MIDKINGIELIA/Protect/Clutch_Ctrl_BD_Rev010/30000009_Clutch_Ctrl_BD_Rev010.SLDPRT

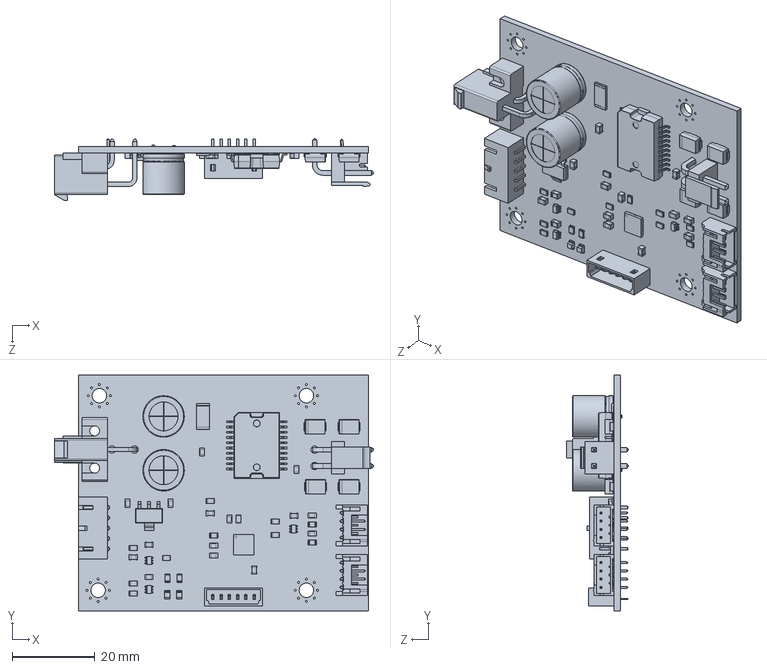
[picture p1: CAD file, 2022-12-25]
Clutch_Ctrl_BD_Rev010/30000009_Clutch_Ctrl_BD_Rev010.SLDPRT
77.0 x 57.0 x 14.9 mm
