MIDKINGIELIA/Protect/Clutch_Ctrl_BD_Rev010/Clutch_Ctrl_BD_Rev010.kicad_pcb

## KiCad design Clutch_Ctrl_BD_Rev010/Clutch_Ctrl_BD_Rev010.kicad_pcb (2022-12-25)

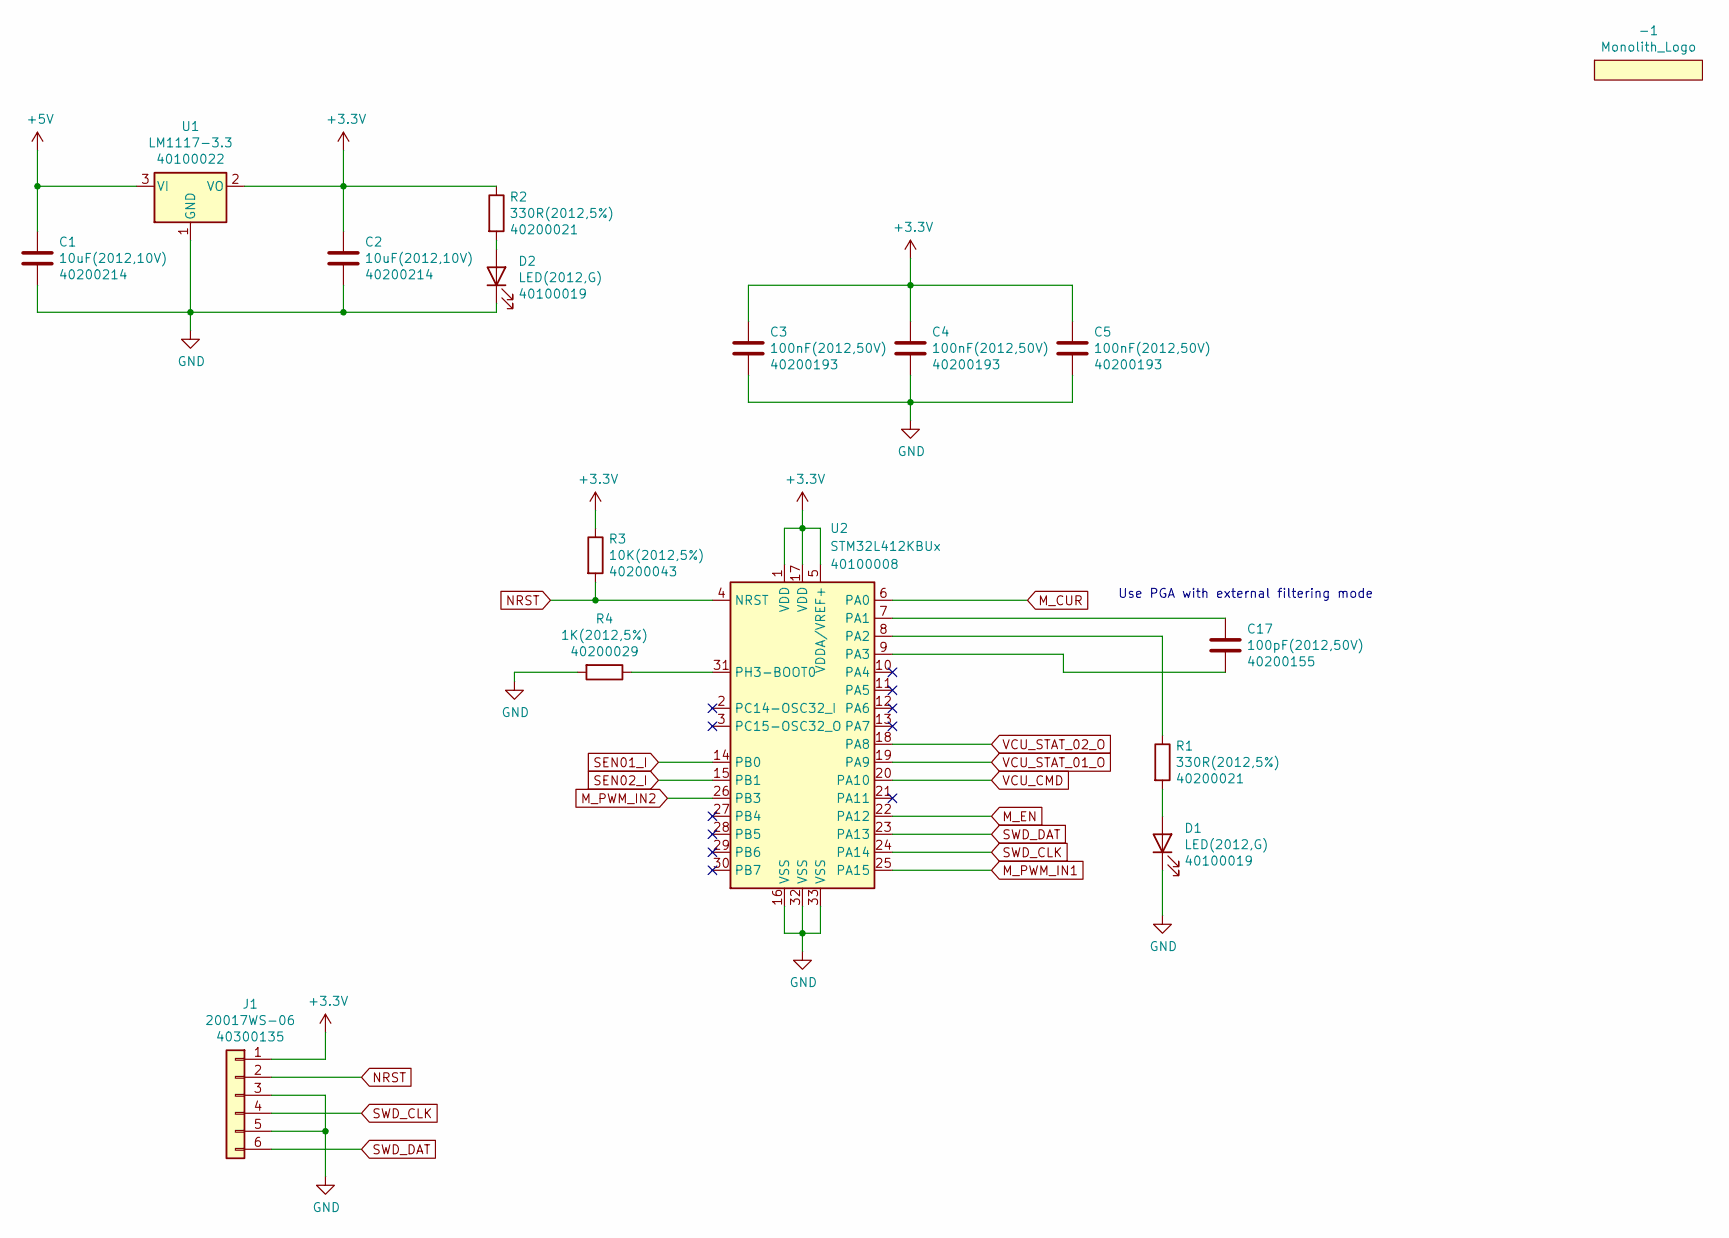
[picture p7: schematic POWER_CPU.sch, POWER & CPU]

Parts:
-1: Monolith_Logo
C1, C2: 10uF(2012,10V); C_0805_2012Metric; PartNo 40200214
C3, C4, C5: 100nF(2012,50V); C_0805_2012Metric; PartNo 40200193
C17: 100pF(2012,50V); C_0805_2012Metric; PartNo 40200155
D1, D2: LED(2012,G); LED_0805_2012Metric; PartNo 40100019
J1: 20017WS-06; Yeonho_20017WS-06_P2.0mm; PartNo 40300135
R1, R2: 330R(2012,5%); R_0805_2012Metric; PartNo 40200021
R3: 10K(2012,5%); R_0805_2012Metric; PartNo 40200043
R4: 1K(2012,5%); R_0805_2012Metric; PartNo 40200029
U1: LM1117-3.3; SOT-223-3_TabPin2; PartNo 40100022
U2: STM32L412KBUx; QFN-32-1EP_5x5mm_P0.5mm_EP3.45x3.45mm; PartNo 40100008

Connections:
+3V3: C2.1, C3.1, C4.1, C5.1, J1.1, R2.1, R3.1, U1.2 (VO), U2.1 (VDD), U2.5 (VDDA/VREF+), U2.17 (VDD); also elsewhere on the board
+5V: C1.1, U1.3 (VI); also elsewhere on the board
GND: C1.2, C2.2, C3.2, C4.2, C5.2, D1.1 (K), D2.1 (K), J1.3, J1.5, R4.2, U1.1 (GND), U2.16 (VSS), U2.32 (VSS), U2.33 (VSS); also elsewhere on the board
M_CUR: U2.6 (PA0); also elsewhere on the board
M_EN: U2.22 (PA12); also elsewhere on the board
M_PWM_IN1: U2.25 (PA15); also elsewhere on the board
M_PWM_IN2: U2.26 (PB3); also elsewhere on the board
NRST: J1.2, R3.2, U2.4 (NRST)
unnamed: C17.1, U2.7 (PA1)
unnamed: C17.2, U2.9 (PA3)
unnamed: D1.2 (A), R1.2
unnamed: D2.2 (A), R2.2
unnamed: R1.1, U2.8 (PA2)
unnamed: R4.1, U2.31 (PH3-BOOT0)
SEN01_I: U2.14 (PB0); also elsewhere on the board
SEN02_I: U2.15 (PB1); also elsewhere on the board
SWD_CLK: J1.4, U2.24 (PA14)
SWD_DAT: J1.6, U2.23 (PA13)
VCU_CMD: U2.20 (PA10); also elsewhere on the board
VCU_STAT_01_O: U2.19 (PA9); also elsewhere on the board
VCU_STAT_02_O: U2.18 (PA8); also elsewhere on the board

Notes on the sheet:
Use PGA with external filtering mode

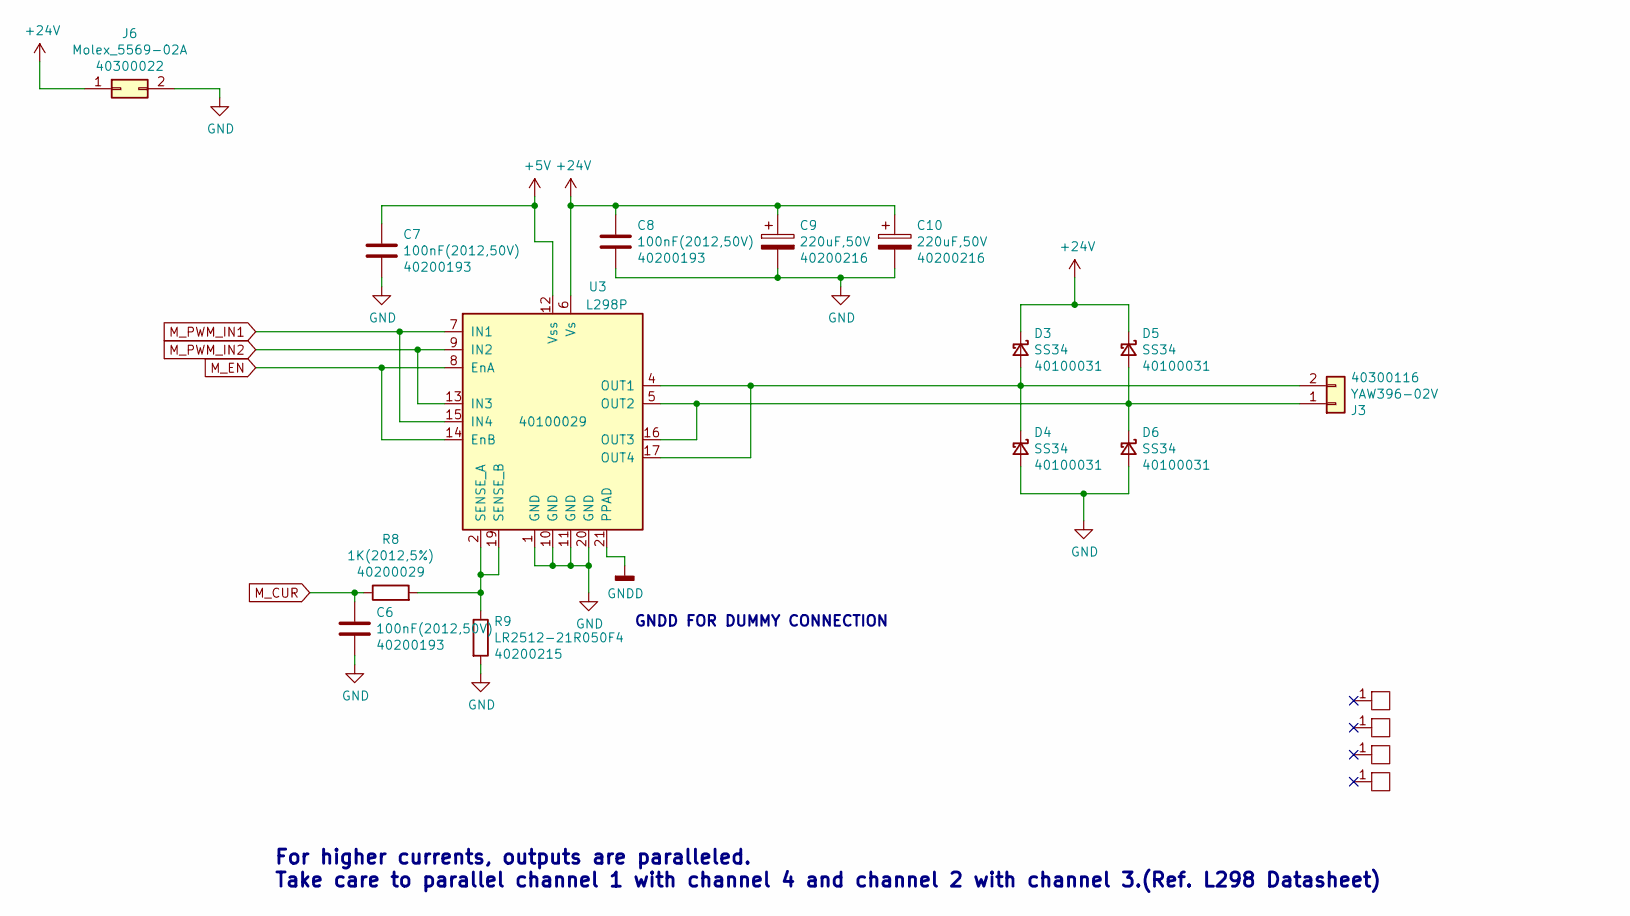
[picture p8: schematic DCM_Driver.sch, DC MOTOR]

Parts:
C6, C7, C8: 100nF(2012,50V); C_0805_2012Metric; PartNo 40200193
C9, C10: 220uF,50V; CP_Radial_D10.0mm_P5.00mm; PartNo 40200216
D3, D4, D5, D6: SS34; D_SMB; PartNo 40100031
H1, H2, H3, H4: PTH-HOLE-M3-CIRCLE; PTH-CIRCLE-M3
J3: YAW396-02V; PartNo 40300116
J6: Molex_5569-02A; Molex_Mini-Fit_Jr_5569-02A1_2x01_P4.20mm_Horizontal; PartNo 40300022
R8: 1K(2012,5%); R_0805_2012Metric; PartNo 40200029
R9: LR2512-21R050F4; R_2512_6332Metric; PartNo 40200215
U3: L298P; HSOP-20-1EP_11.0x15.9mm_P1.27mm_SlugDown; PartNo 40100029

Connections:
+5V: C7.1, U3.12 (Vss); also elsewhere on the board
+24V: C8.1, C9.1, C10.1, D3.1 (K), D5.1 (K), J6.1, U3.6 (Vs)
GND: C6.2, C7.2, C8.2, C9.2, C10.2, D4.2 (A), D6.2 (A), J6.2, R9.2, U3.1 (GND), U3.10 (GND), U3.11 (GND), U3.20 (GND); also elsewhere on the board
GNDD: U3.21 (PPAD)
M_CUR: C6.1, R8.1; also elsewhere on the board
M_EN: U3.8 (EnA), U3.14 (EnB); also elsewhere on the board
M_PWM_IN1: U3.7 (IN1), U3.15 (IN4); also elsewhere on the board
M_PWM_IN2: U3.9 (IN2), U3.13 (IN3); also elsewhere on the board
unnamed: D3.2 (A), D4.1 (K), J3.2, U3.4 (OUT1), U3.17 (OUT4)
unnamed: D5.2 (A), D6.1 (K), J3.1, U3.5 (OUT2), U3.16 (OUT3)
unnamed: R8.2, R9.1, U3.2 (SENSE_A), U3.19 (SENSE_B)

Notes on the sheet:
For higher currents, outputs are paralleled. Take care to parallel channel 1 with channel 4 and channel 2 with channel 3.(Ref. L298 Datasheet)
GNDD FOR DUMMY CONNECTION

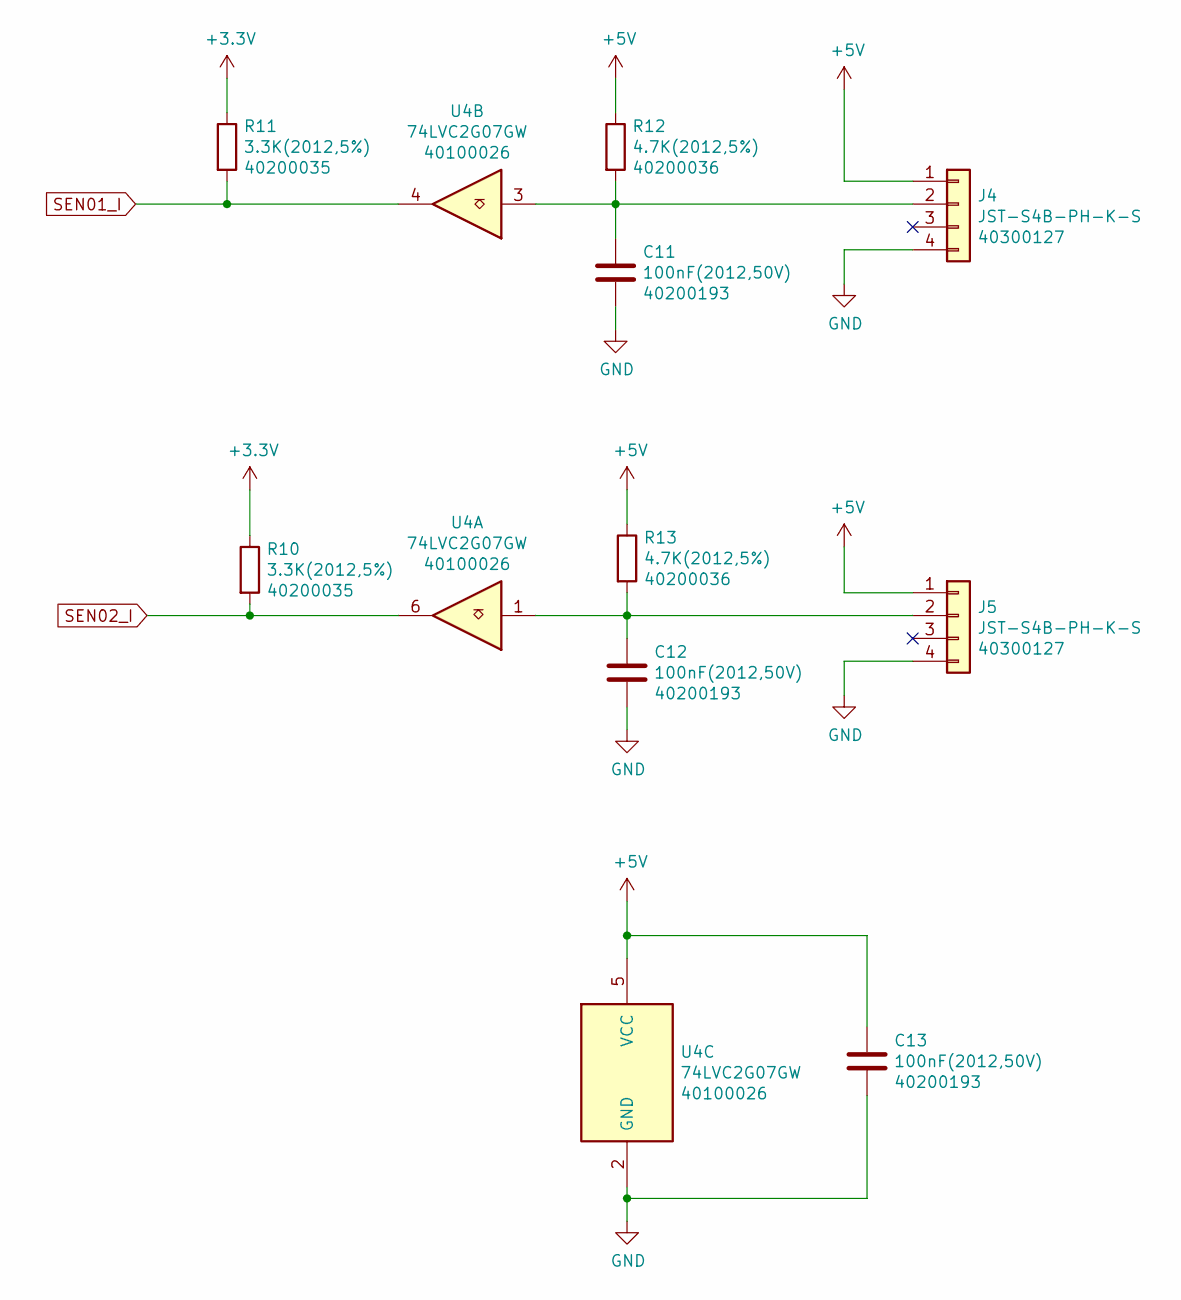
[picture p9: schematic SENSOR.sch, SENSOR IF]

Parts:
C11, C12, C13: 100nF(2012,50V); C_0805_2012Metric; PartNo 40200193
J4, J5: JST-S4B-PH-K-S; JST_PH_S4B-PH-K_1x04_P2.00mm_Horizontal; PartNo 40300127
R10, R11: 3.3K(2012,5%); R_0805_2012Metric; PartNo 40200035
R12, R13: 4.7K(2012,5%); R_0805_2012Metric; PartNo 40200036
U4: 74LVC2G07GW; SOT-363_SC-70-6; PartNo 40100026

Connections:
+3V3: R10.1, R11.1; also elsewhere on the board
+5V: C13.1, J4.1, J5.1, R12.1, R13.1, U4.5 (VCC); also elsewhere on the board
GND: C11.2, C12.2, C13.2, J4.4, J5.4, U4.2 (GND); also elsewhere on the board
unnamed: C11.1, J4.2, R12.2, U4.3
unnamed: C12.1, J5.2, R13.2, U4.1
SEN01_I: R11.2, U4.4; also elsewhere on the board
SEN02_I: R10.2, U4.6; also elsewhere on the board

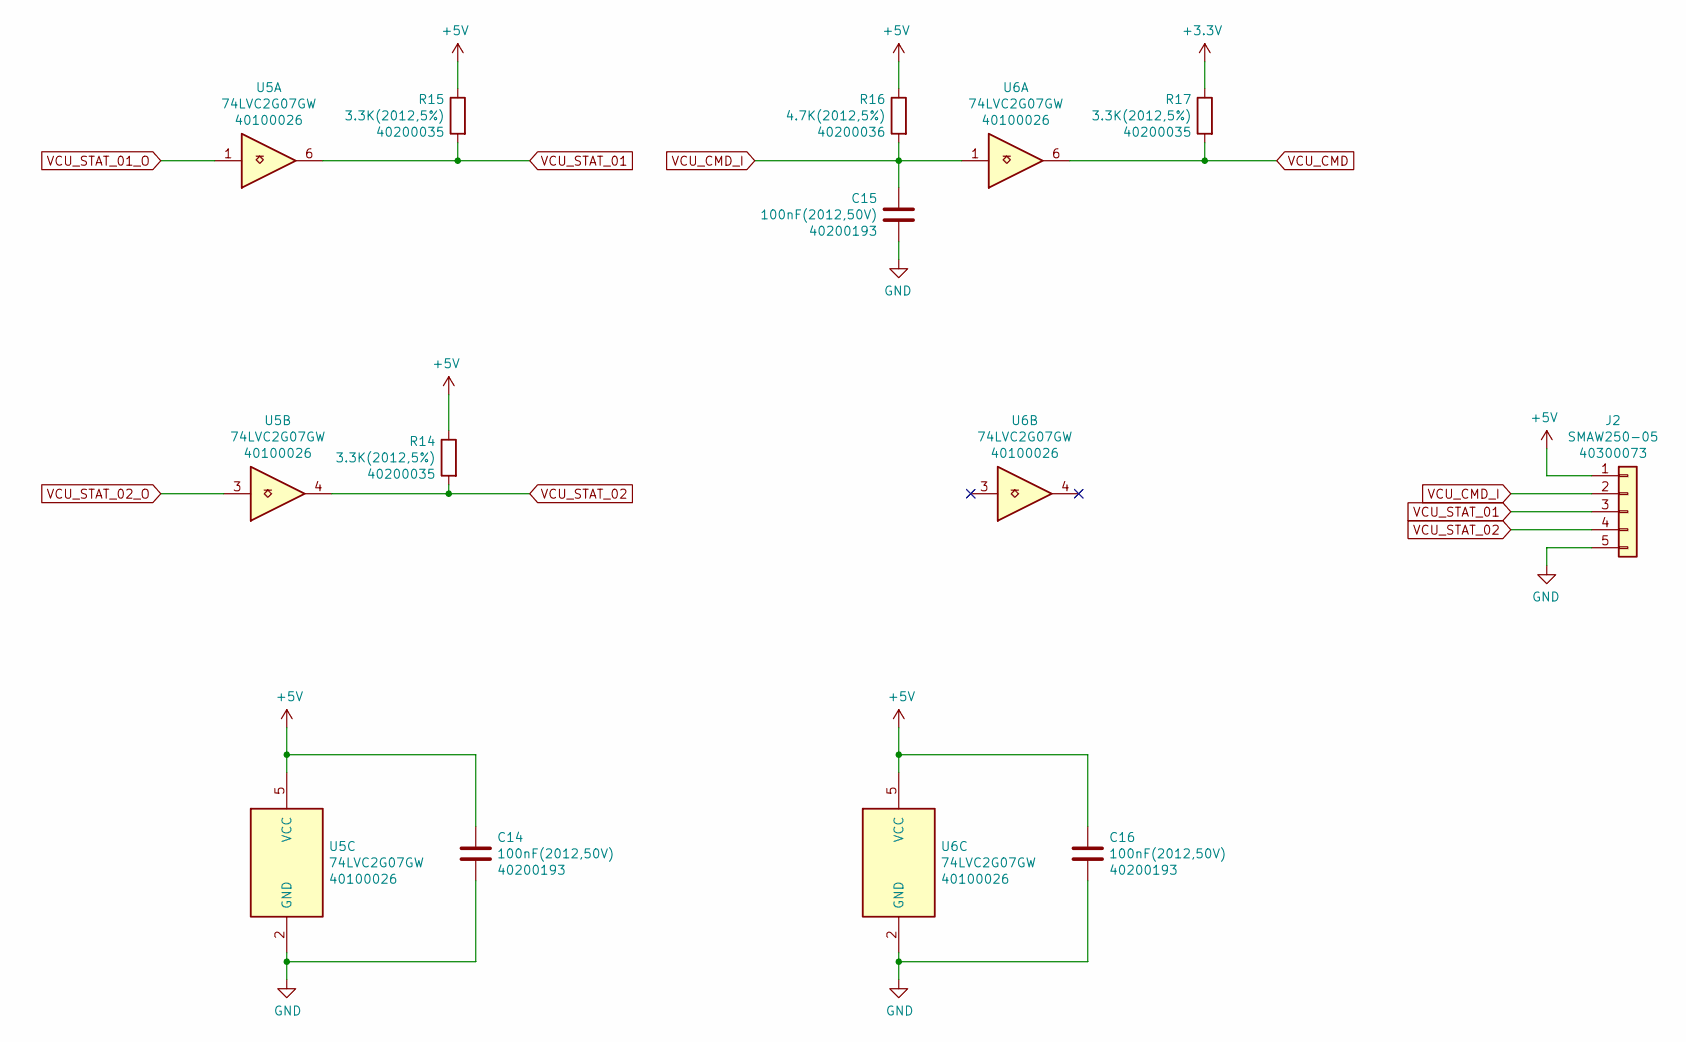
[picture p10: schematic VCU_IF.sch, VCU IF]

Parts:
C14, C15, C16: 100nF(2012,50V); C_0805_2012Metric; PartNo 40200193
J2: SMAW250-05; PartNo 40300073
R14, R15, R17: 3.3K(2012,5%); R_0805_2012Metric; PartNo 40200035
R16: 4.7K(2012,5%); R_0805_2012Metric; PartNo 40200036
U5, U6: 74LVC2G07GW; SOT-363_SC-70-6; PartNo 40100026

Connections:
+3V3: R17.1; also elsewhere on the board
+5V: C14.1, C16.1, J2.1, R14.1, R15.1, R16.1, U5.5 (VCC), U6.5 (VCC); also elsewhere on the board
GND: C14.2, C15.2, C16.2, J2.5, U5.2 (GND), U6.2 (GND); also elsewhere on the board
VCU_CMD: R17.2, U6.6; also elsewhere on the board
VCU_CMD_I: C15.1, J2.2, R16.2, U6.1
VCU_STAT_01: J2.3, R15.2, U5.6
VCU_STAT_01_O: U5.1; also elsewhere on the board
VCU_STAT_02: J2.4, R14.2, U5.4
VCU_STAT_02_O: U5.3; also elsewhere on the board

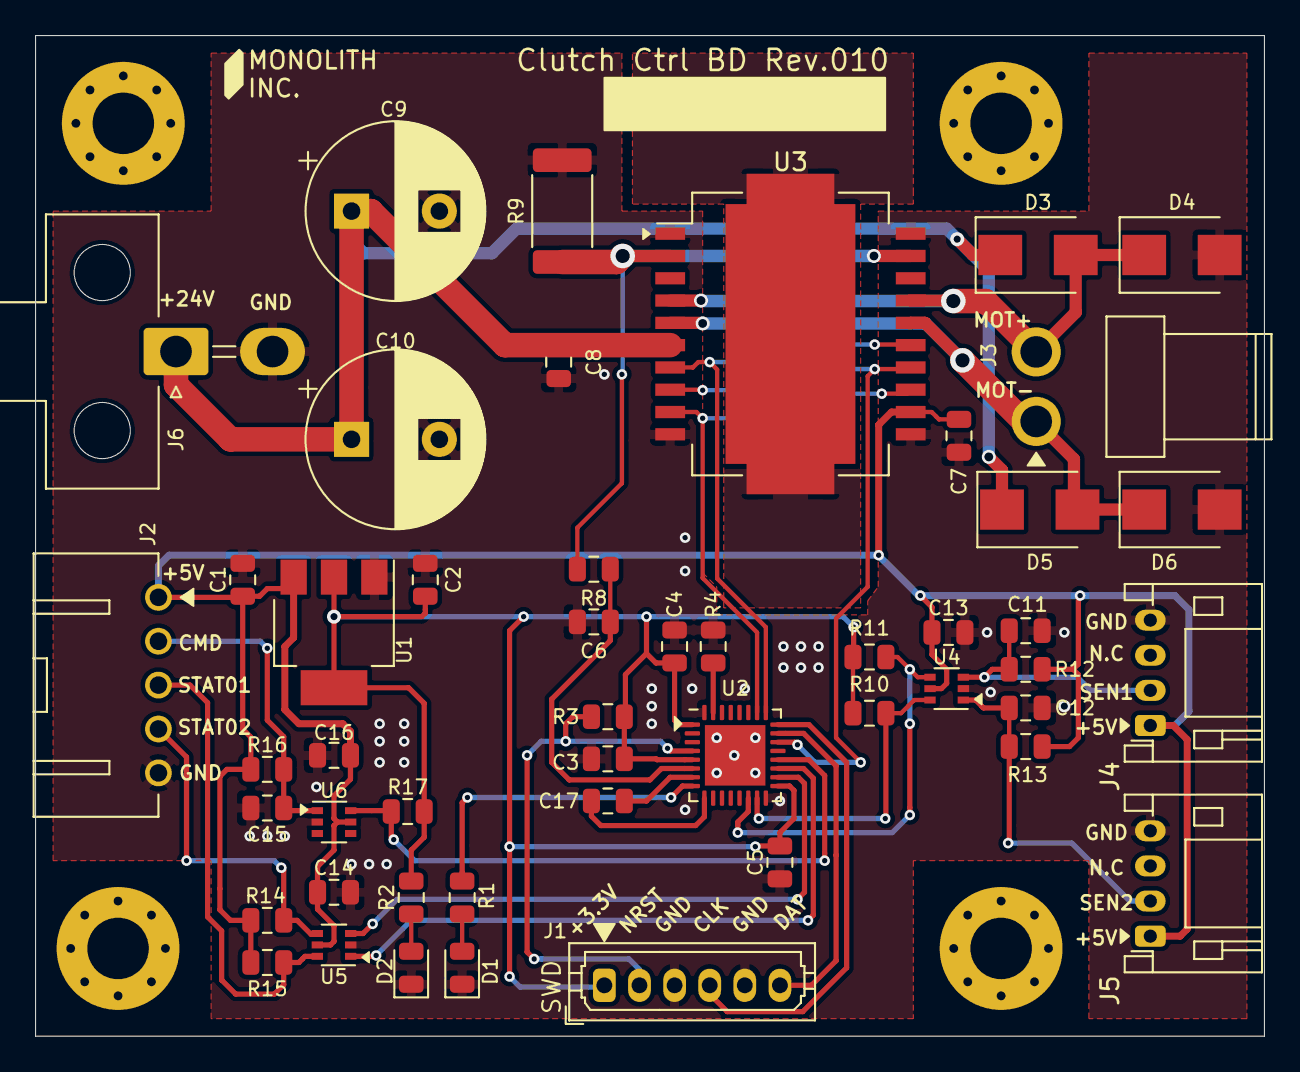
[picture p11: board Clutch_Ctrl_BD_Rev010.kicad_pcb from above]

Board: 2 copper layers, 70.0 x 57.0 mm, 54 parts (0 on the bottom side), 30 nets.
